jnedbal/MicroFLiC_LCD_1_2/MicroFLiC_LCD_Seeed.csv

Part/Designator | Manufacture Part Number/Seeed SKU | Quantity
C1,C2,C4,C6 | 302010165 | 4
C3,C5,C7 | 302010146 | 3
R2,R4,R5,R6 | 301010361 | 4
