jnedbal/MicroFLiC_LCD_1_2/MicroFLiC_LCD.kicad_pcb

## KiCad design MicroFLiC_LCD.kicad_pcb (2016-06-24)

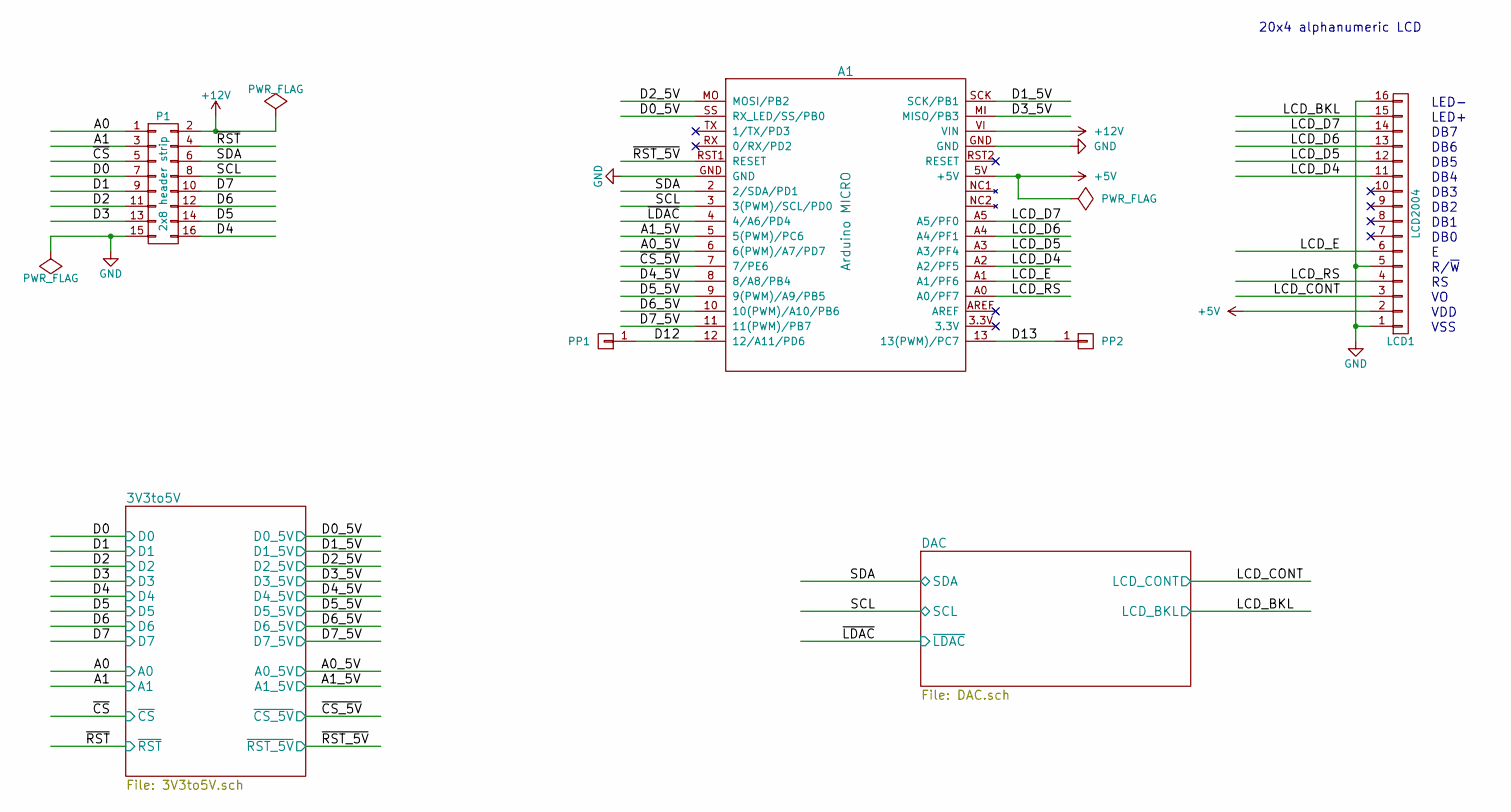
[picture p1: schematic MicroFLiC_LCD.sch]

Parts:
A1: Arduino MICRO; ArduinoMicro; Part Number A000053
LCD1: LCD2004; Part Number MC42005A12W-VNMLR
P1: 2x8 header strip; Pin_Header_Straight_2x08; Part Number M20-9980845
PP1, PP2: CONN_01X01; PIN_ARRAY_1

Connections:
+5V: A1.5V (+5V), LCD1.2; also elsewhere on the board
+12V: A1.VI (VIN), P1.2; also elsewhere on the board
/3V3to5V/A0: P1.1; also elsewhere on the board
/3V3to5V/A0_5V: A1.6 (6(PWM)/A7/PD7); also elsewhere on the board
/3V3to5V/A1: P1.3; also elsewhere on the board
/3V3to5V/A1_5V: A1.5 (5(PWM)/PC6); also elsewhere on the board
/3V3to5V/D0: P1.7; also elsewhere on the board
/3V3to5V/D0_5V: A1.SS (RX_LED/SS/PB0); also elsewhere on the board
/3V3to5V/D1: P1.9; also elsewhere on the board
/3V3to5V/D1_5V: A1.SCK (SCK/PB1); also elsewhere on the board
/3V3to5V/D2: P1.11; also elsewhere on the board
/3V3to5V/D2_5V: A1.MO (MOSI/PB2); also elsewhere on the board
/3V3to5V/D3: P1.13; also elsewhere on the board
/3V3to5V/D3_5V: A1.MI (MISO/PB3); also elsewhere on the board
/3V3to5V/D4: P1.16; also elsewhere on the board
/3V3to5V/D4_5V: A1.8 (8/A8/PB4); also elsewhere on the board
/3V3to5V/D5: P1.14; also elsewhere on the board
/3V3to5V/D5_5V: A1.9 (9(PWM)/A9/PB5); also elsewhere on the board
/3V3to5V/D6: P1.12; also elsewhere on the board
/3V3to5V/D6_5V: A1.10 (10(PWM)/A10/PB6); also elsewhere on the board
/3V3to5V/D7: P1.10; also elsewhere on the board
/3V3to5V/D7_5V: A1.11 (11(PWM)/PB7); also elsewhere on the board
/3V3to5V/~CS: P1.5; also elsewhere on the board
/3V3to5V/~CS_5V: A1.7 (7/PE6); also elsewhere on the board
/3V3to5V/~RST: P1.4; also elsewhere on the board
/3V3to5V/~RST_5V: A1.RST1 (RESET); also elsewhere on the board
/D12: A1.12 (12/A11/PD6), PP1.1
/D13: A1.13 (13(PWM)/PC7), PP2.1
/DAC/LCD_BKL: LCD1.15; also elsewhere on the board
/DAC/LCD_CONT: LCD1.3; also elsewhere on the board
/DAC/SCL: A1.3 (3(PWM)/SCL/PD0), P1.8; also elsewhere on the board
/DAC/SDA: A1.2 (2/SDA/PD1), P1.6; also elsewhere on the board
/DAC/~LDAC: A1.4 (4/A6/PD4); also elsewhere on the board
/LCD_D4: A1.A2 (A2/PF5), LCD1.11
/LCD_D5: A1.A3 (A3/PF4), LCD1.12
/LCD_D6: A1.A4 (A4/PF1), LCD1.13
/LCD_D7: A1.A5 (A5/PF0), LCD1.14
/LCD_E: A1.A1 (A1/PF6), LCD1.6
/LCD_RS: A1.A0 (A0/PF7), LCD1.4
GND: A1.GND, LCD1.1, LCD1.5, LCD1.16, P1.15; also elsewhere on the board

Notes on the sheet:
LED-
LED+
DB7
DB6
DB5
DB4
DB3
DB2
DB1
DB0
R/~W
VDD
VSS
20x4 alphanumeric LCD

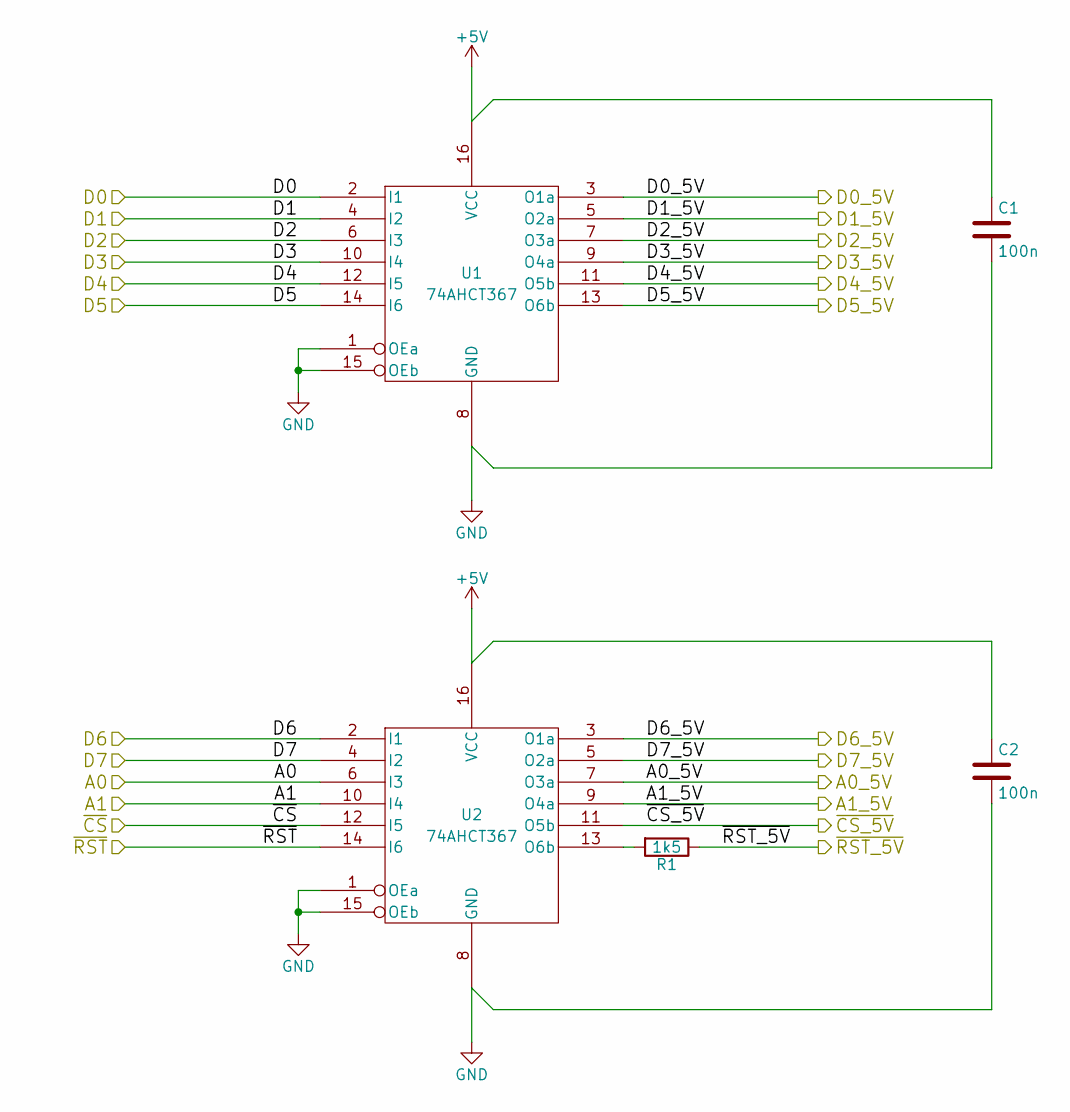
[picture p2: schematic 3V3to5V.sch]

Parts:
C1, C2: 100n; C_0805; Part Number MC0805B104K250CT
R1: 1k5; R_0805; Part Number MCWR08X1501FTL
U1, U2: 74AHCT367; SOIC-16_3.9x9.9mm_Pitch1.27mm; Part Number SN74AHCT367D

Connections:
+5V: C1.1, C2.1, U1.16 (VCC), U2.16 (VCC); also elsewhere on the board
/3V3to5V/A0: U2.6 (I3); also elsewhere on the board
/3V3to5V/A0_5V: U2.7 (O3a); also elsewhere on the board
/3V3to5V/A1: U2.10 (I4); also elsewhere on the board
/3V3to5V/A1_5V: U2.9 (O4a); also elsewhere on the board
/3V3to5V/D0: U1.2 (I1); also elsewhere on the board
/3V3to5V/D0_5V: U1.3 (O1a); also elsewhere on the board
/3V3to5V/D1: U1.4 (I2); also elsewhere on the board
/3V3to5V/D1_5V: U1.5 (O2a); also elsewhere on the board
/3V3to5V/D2: U1.6 (I3); also elsewhere on the board
/3V3to5V/D2_5V: U1.7 (O3a); also elsewhere on the board
/3V3to5V/D3: U1.10 (I4); also elsewhere on the board
/3V3to5V/D3_5V: U1.9 (O4a); also elsewhere on the board
/3V3to5V/D4: U1.12 (I5); also elsewhere on the board
/3V3to5V/D4_5V: U1.11 (O5b); also elsewhere on the board
/3V3to5V/D5: U1.14 (I6); also elsewhere on the board
/3V3to5V/D5_5V: U1.13 (O6b); also elsewhere on the board
/3V3to5V/D6: U2.2 (I1); also elsewhere on the board
/3V3to5V/D6_5V: U2.3 (O1a); also elsewhere on the board
/3V3to5V/D7: U2.4 (I2); also elsewhere on the board
/3V3to5V/D7_5V: U2.5 (O2a); also elsewhere on the board
/3V3to5V/~CS: U2.12 (I5); also elsewhere on the board
/3V3to5V/~CS_5V: U2.11 (O5b); also elsewhere on the board
/3V3to5V/~RST: U2.14 (I6); also elsewhere on the board
/3V3to5V/~RST_5V: R1.1; also elsewhere on the board
GND: C1.2, C2.2, U1.1 (OEa), U1.8 (GND), U1.15 (OEb), U2.1 (OEa), U2.8 (GND), U2.15 (OEb); also elsewhere on the board
unnamed: R1.2, U2.13 (O6b)

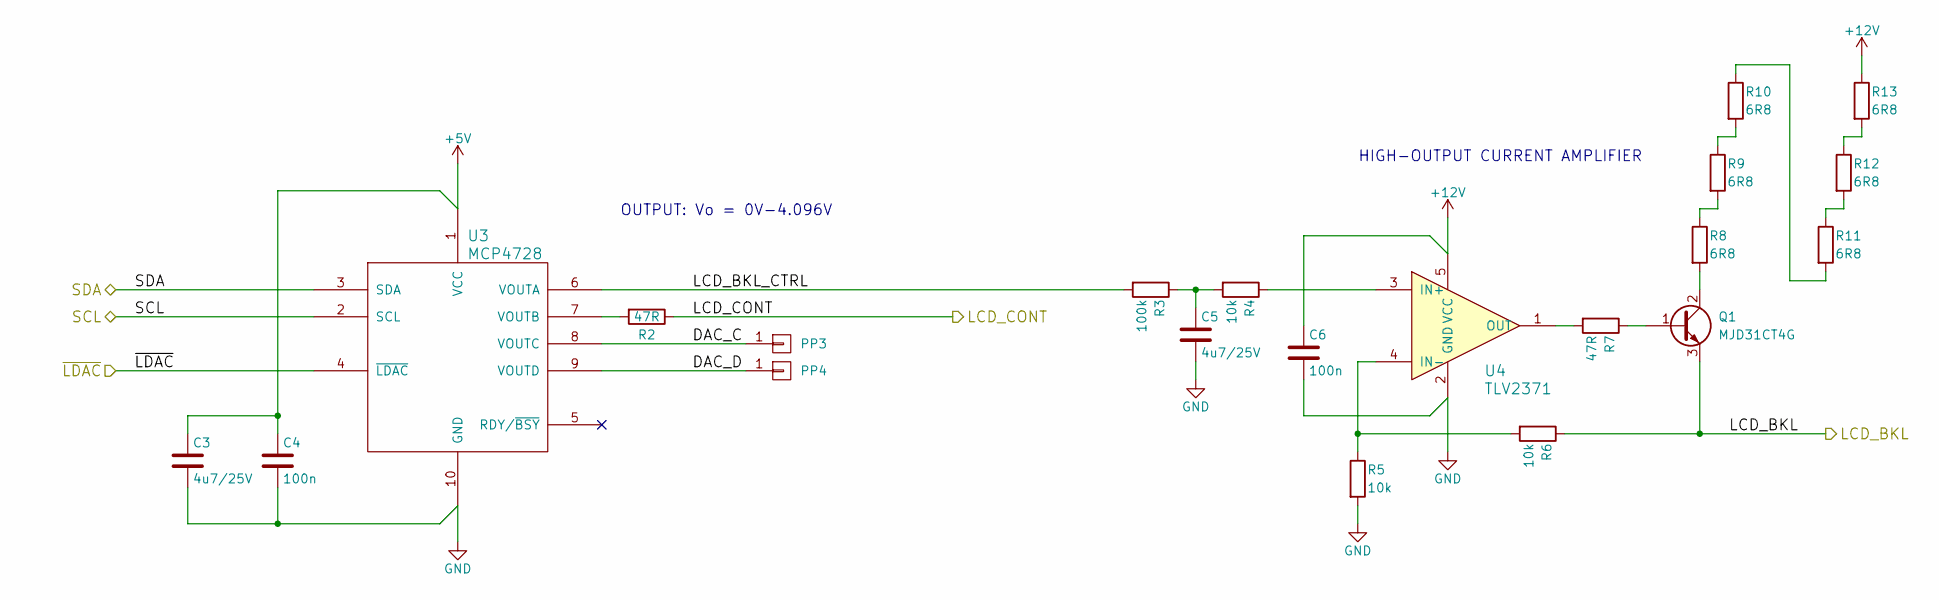
[picture p3: schematic DAC.sch]

Parts:
C3, C5: 4u7/25V; C_0805; Part Number GRM21BR61E475MA12L
C4, C6: 100n; C_0805; Part Number MC0805B104K250CT
PP3, PP4: CONN_01X01; PIN_ARRAY_1
Q1: MJD31CT4G; TO-252-2Lead; Part Number MJD31CT4G
R2, R7: 47R; R_0805; Part Number MCWR08X47R0FTL
R3: 100k; R_0805; Part Number MCWR08X1003FTL
R4, R5, R6: 10k; R_0805; Part Number MCMR08X1002FTL
R8, R9, R10, R11, R12, R13: 6R8; R_0805; Part Number MC01W080516R8
U3: MCP4728; MSOP-10_3x3mm_Pitch0.5mm; Part Number MCP4728-E/UN
U4: TLV2371; SOT-23-5; Part Number TLV2371IDBVT

Connections:
+5V: C3.1, C4.1, U3.1 (VCC); also elsewhere on the board
+12V: C6.1, R13.1, U4.5 (VCC); also elsewhere on the board
/DAC/DAC_C: PP3.1, U3.8 (VOUTC)
/DAC/DAC_D: PP4.1, U3.9 (VOUTD)
/DAC/LCD_BKL: Q1.3 (E), R6.1; also elsewhere on the board
/DAC/LCD_BKL_CTRL: R3.2, U3.6 (VOUTA)
/DAC/LCD_CONT: R2.1; also elsewhere on the board
/DAC/SCL: U3.2 (SCL); also elsewhere on the board
/DAC/SDA: U3.3 (SDA); also elsewhere on the board
/DAC/~LDAC: U3.4 (~LDAC); also elsewhere on the board
GND: C3.2, C4.2, C5.2, C6.2, R5.2, U3.10 (GND), U4.2 (GND); also elsewhere on the board
unnamed: C5.1, R3.1, R4.2
unnamed: Q1.1 (B), R7.1
unnamed: Q1.2 (C), R8.2
unnamed: R2.2, U3.7 (VOUTB)
unnamed: R4.1, U4.3 (IN+)
unnamed: R5.1, R6.2, U4.4 (IN-)
unnamed: R7.2, U4.1 (OUT)
unnamed: R8.1, R9.2
unnamed: R10.1, R11.2
unnamed: R9.1, R10.2
unnamed: R11.1, R12.2
unnamed: R12.1, R13.2

Notes on the sheet:
OUTPUT: Vo = 0V-4.096V
HIGH-OUTPUT CURRENT AMPLIFIER

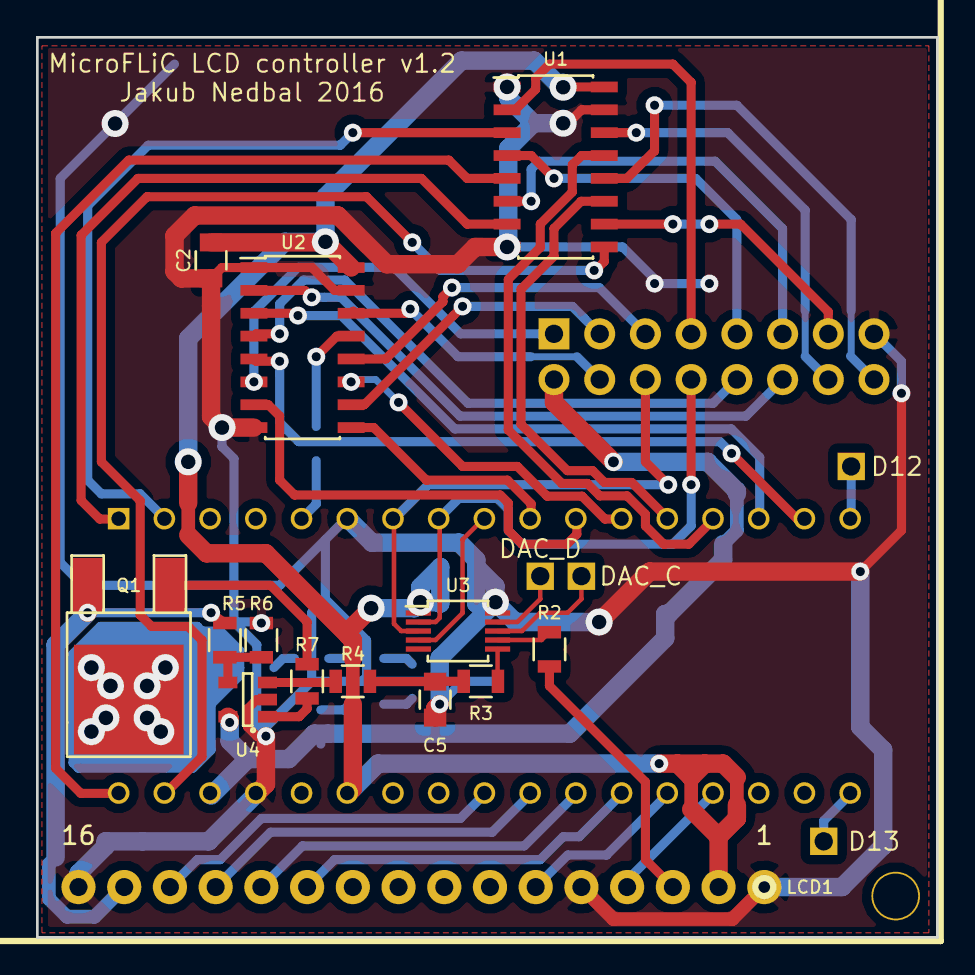
[picture p4: board MicroFLiC_LCD.kicad_pcb from above]

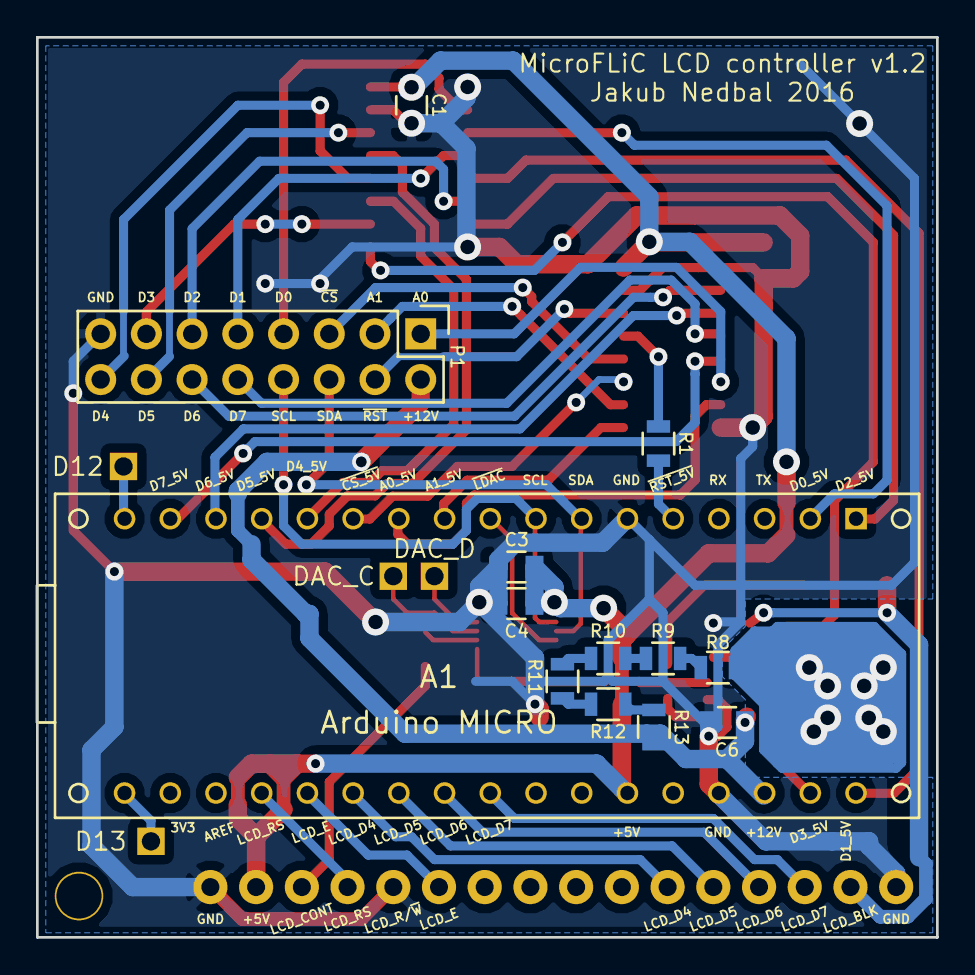
[picture p5: board MicroFLiC_LCD.kicad_pcb from below]

Board: 2 copper layers, 50.0 x 50.0 mm, 31 parts (13 on the bottom side), 56 nets.
