jnedbal/MicroFLiC_LCD_1_2/MicroFLiC_LCD_1_0.kicad_pcb

## KiCad design MicroFLiC_LCD_1_0.kicad_pcb (2016-01-06)

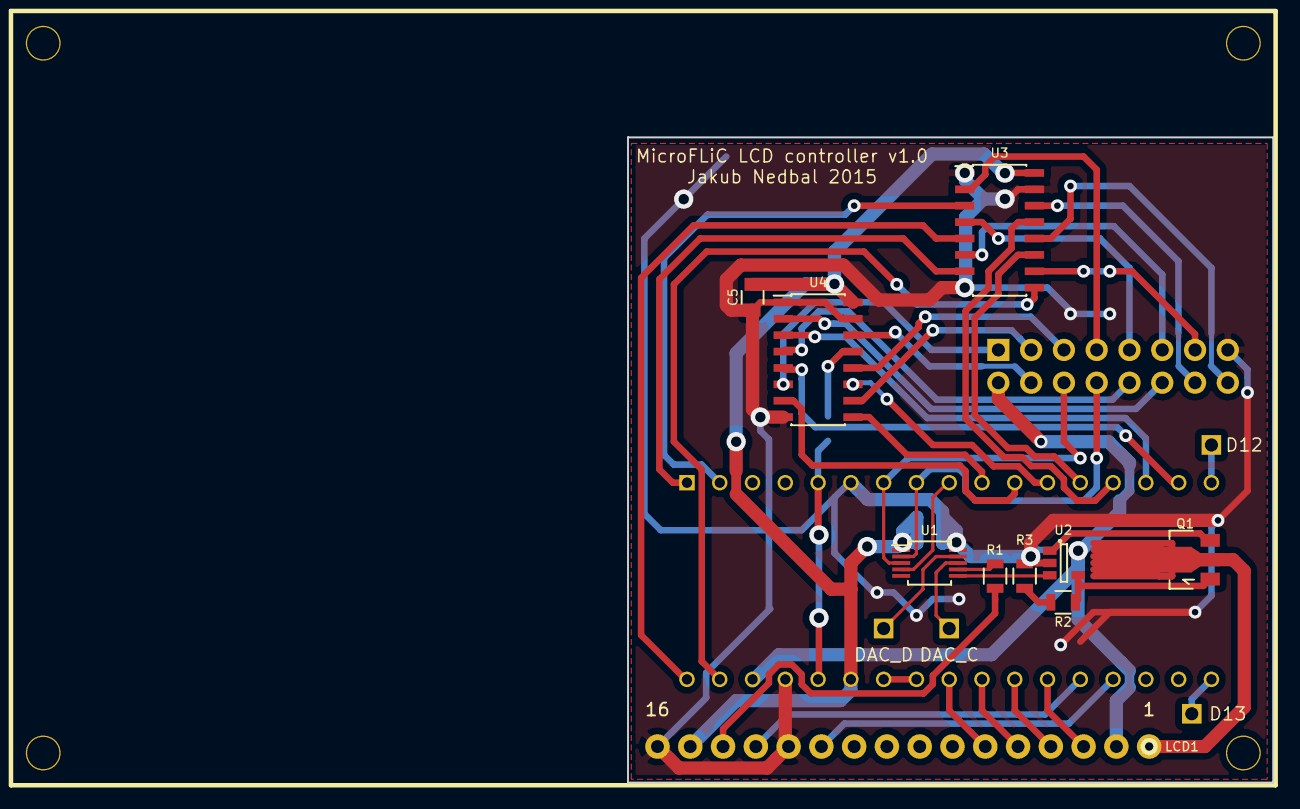
[picture p6: board MicroFLiC_LCD_1_0.kicad_pcb from above]

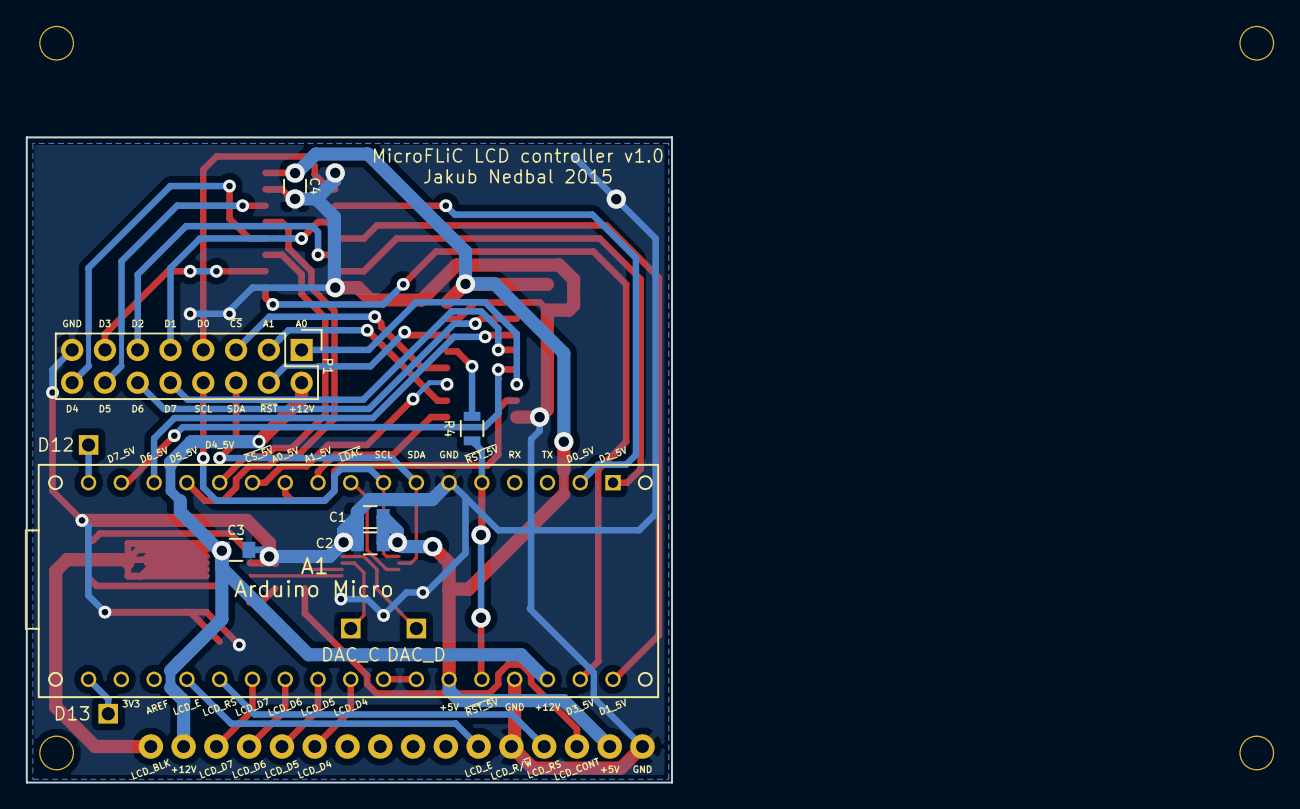
[picture p7: board MicroFLiC_LCD_1_0.kicad_pcb from below]

Board: 2 copper layers, 50.0 x 50.0 mm, 21 parts (7 on the bottom side), 48 nets.

Parts:
A1: Arduino Micro; ArduinoMicro
C1: 10u; C_0805
C2, C3: 100n; C_0805
C4, C5: C; C_0805
LCD1: LCD2004
P1: CONN_02X08; Pin_Header_Straight_2x08
PP1, PP2, PP3, PP4: CONN_01X01; PIN_ARRAY_1
Q1: BCX54-16; SOT89-3_Housing
R1: 10k; R_0805
R2, R3: 27R; R_0805
R4: 1K5; R_0805
U1: MCP4728; MSOP-10_3x3mm_Pitch0.5mm
U2: TLV2371; SOT-23-5
U3, U4: 74AHCT367; SOIC-16_3.9x9.9mm_Pitch1.27mm

Connections:
+5V: A1.5V, C1.1, C2.1, C4.1, C5.1, LCD1.15, U1.1, U3.16, U4.16
+12V: A1.VI, C3.1, LCD1.2, P1.2, U2.5
/3V3to5V/A0: P1.1, U4.6
/3V3to5V/A0_5V: A1.6, U4.7
/3V3to5V/A1: P1.3, U4.10
/3V3to5V/A1_5V: A1.5, U4.9
/3V3to5V/D0: P1.7, U3.2
/3V3to5V/D0_5V: A1.SS, U3.3
/3V3to5V/D1: P1.9, U3.4
/3V3to5V/D1_5V: A1.SCK, U3.5
/3V3to5V/D2: P1.11, U3.6
/3V3to5V/D2_5V: A1.MO, U3.7
/3V3to5V/D3: P1.13, U3.10
/3V3to5V/D3_5V: A1.MI, U3.9
/3V3to5V/D4: P1.16, U3.12
/3V3to5V/D4_5V: A1.8, U3.11
/3V3to5V/D5: P1.14, U3.14
/3V3to5V/D5_5V: A1.9, U3.13
/3V3to5V/D6: P1.12, U4.2
/3V3to5V/D6_5V: A1.10, U4.3
/3V3to5V/D7: P1.10, U4.4
/3V3to5V/D7_5V: A1.11, U4.5
/3V3to5V/~CS: P1.5, U4.12
/3V3to5V/~CS_5V: A1.7, U4.11
/3V3to5V/~RST: P1.4, U4.14
/3V3to5V/~RST_5V: A1.RST, R4.1
/D12: A1.12, PP1.1
/D13: A1.13, PP4.1
/DAC_C: PP2.1, U1.8
/DAC_D: PP3.1, U1.9
/LCD_BKL: LCD1.1, Q1.2
/LCD_BKL_CTRL: U1.6, U2.3
/LCD_CONT: LCD1.14, R1.1
/LCD_D4: A1.A5, LCD1.6
/LCD_D5: A1.A4, LCD1.5
/LCD_D6: A1.A3, LCD1.4
/LCD_D7: A1.A2, LCD1.3
/LCD_E: A1.A0, LCD1.11
/LCD_RS: A1.A1, LCD1.13
/SCL: A1.3, P1.8, U1.2
/SDA: A1.2, P1.6, U1.3
/~LDAC: A1.4, U1.4
GND: A1.GND, C1.2, C2.2, C3.2, C4.2, C5.2, LCD1.12, LCD1.16, P1.15, R3.2, U1.10, U2.2, U3.1, U3.8, U3.15, U4.1, U4.8, U4.15
unnamed: Q1.1, R2.1, U2.4
unnamed: Q1.3, U2.1
unnamed: R1.2, U1.7
unnamed: R2.2, R3.1
unnamed: R4.2, U4.13
