jnedbal/MicroFLiC_LCD_1_2/(commit log)

2015-12-12 Schematics is ready
    [MicroFLiC_LCD_1_0.kicad_pcb, MicroFLiC_LCD_1_0.sch]
2015-12-12 Created the PCB with 3D models
    [MicroFLiC_LCD_1_0.kicad_pcb, MicroFLiC_LCD_1_0.sch]
2016-01-06 Final production board v1.0. Corrected LCD part v1.1
    [3V3to5V.sch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]
2016-02-19 Added connectors for LCD to the schematics
    [3V3to5V.sch, MicroFLiC_LCD_1_0.csv, MicroFLiC_LCD_1_0.sch]
2016-02-26 Renamed files, added part description
    [3V3to5V.sch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]
2016-03-02 Fixed label of 1k5 resistor
    [3V3to5V.sch, MicroFLiC_LCD.csv, MicroFLiC_LCD.kicad_pcb]
2016-03-02 Fixed LCD part description
    [MicroFLiC_LCD.csv, MicroFLiC_LCD.sch]
2016-03-18 Fixed LCD orientation, added powerful emitter-follower amplifier
    [3V3to5V.sch, DAC.sch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]
2016-03-21 Changed 47R resistor part number
    [DAC.sch]
2016-03-23 Finalized PCB for production
    [3V3to5V.sch, DAC.sch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]
2016-05-24 Fixed silk arrangement to avoid overlaps
    [MicroFLiC_LCD.kicad_pcb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]
2016-06-23 Organized the transistor label a bit.
    [DAC.sch]
2016-06-24 Added current-limiting resistors on the LCD backlight
    [DAC.sch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]
2016-06-24 Changed resistors on the PCB
    [DAC.sch, MicroFLiC_LCD.csv, MicroFLiC_LCD.kicad_pcb]
